proegssilb/lightsaber-hardware/system-board/system-board.kicad_pcb

## KiCad design system-board/system-board.kicad_pcb (2023-07-27)

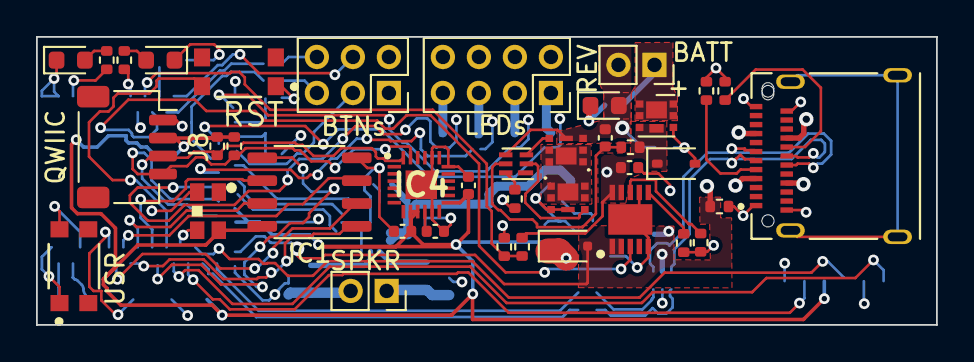
[picture p1: board system-board.kicad_pcb from above]

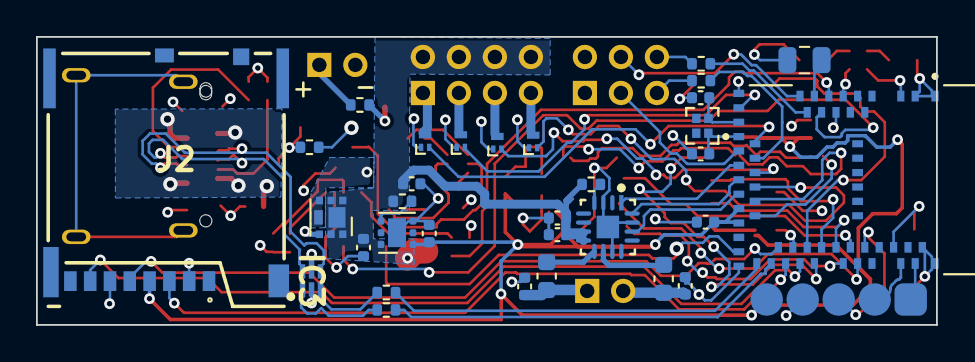
[picture p2: board system-board.kicad_pcb from below]

Board: 4 copper layers, 50.0 x 16.0 mm, 72 parts (33 on the bottom side), 74 nets.

Parts:
C1, C7, C9, C13: 10u; C_0402_1005Metric
C2, C3: 22p; C_0402_1005Metric
C4: 0.1 uF; C_0805_2012Metric
C5, C6: 220p; C_0402_1005Metric
C8: 100 nF; C_0402_1005Metric
C10, C14, C15, C16: 0.1 uF; C_0402_1005Metric
C11, C12: 4.7u; C_0402_1005Metric
D1: WS2812B-2020
D2: BLUE; LED_0603_1608Metric
D3: RED; LED_0603_1608Metric
D4: BZX38450; D_SOD-323
D5: REV; LED_0603_1608Metric
D6: PMEG1030EJ; D_SOD-323F
FB1, FB2: FB_Sm; C_0603_1608Metric
IC1: Flash_16Mb; SOP-8_3.9x4.9mm_P1.27mm
IC2: MCP73834T-FCI_MF; SON50P300X300X100-11N-D
IC3: HSP061-2M6; SON50P100X145X65-6N-D
IC4: ICM-20648; QFN40P300X300X95-25N-D
J1: BATT; PinSocket_1x02_P2.00mm_Vertical
J2: 503398-1892; Molex uSD Card Holder Push-Push 503398-1892
J3: DBG; Prog-Pads
J4: SPKR; PinSocket_1x02_P2.00mm_Vertical
J5: LEDs; PinSocket_2x04_P2.00mm_Vertical
J6: BTNs; PinSocket_2x03_P2.00mm_Vertical
J7: 105450-0101; AMPHENOL_12401832E402A
J8: QWIIC; JST_SH_SM04B-SRSS-TB_1x04-1MP_P1.00mm_Horizontal
Q1, Q4: DMP1012UFDF
Q2, Q3: SSM6K504NU.LF; SSM6K504NULF
Q5, Q6, Q7, Q8: PMZB290UNE2YL; Diodes_DFN1006-3
R1, R2: 22; R_0402_1005Metric
R3, R4, R10, R16, R17: 1k; R_0402_1005Metric
R5: 1M; R_0402_1005Metric
R6: 330; R_0402_1005Metric
R7: 2.2k; R_0402_1005Metric
R8, R20, R21: 2.0k; R_0402_1005Metric
R9: 10k; R_0402_1005Metric
R11: 200; R_0402_1005Metric
R12, R13, R14, R15: 100k; R_0402_1005Metric
R18, R19: 5k1; R_0402_1005Metric
SW1: RST; CK_Components-KMR231NG_LFS-MFG
SW2: USR; CK_Components-KMR231NG_LFS-MFG
U1: MDBT50Q-1MV2; XCVR_MDBT50Q-1MV2
U2: MAX98357AETE+T; Maxim_Integrated-T1633-4-0-V-IPC_C
U3: BQ29705DSER; WSON-6_1.5x1.5mm_P0.5mm
U4: TLV75733PDRV; WSON-6-1EP_2x2mm_P0.65mm_EP1x1.6mm
Y1: 32.768k; XTAL_ECS-.327-12.5-1210B-N-TR

Connections:
/A0: J6.3, U1.20 (P0.04/AIN2)
/A1: R17.2, U1.21 (P0.05/AIN3)
/A2: J6.4, U1.14 (P0.30/AIN6)
/A3: R16.2, U1.13 (P0.28/AIN4)
/A4: IC2.3 (STAT1), U1.11 (P0.02/AIN0)
/AREF: C4.2, U1.12 (P0.31/AIN7)
/Blade LED Out/Blade_1_Out: J5.1, Q5.3 (S)
/Blade LED Out/Blade_2_Out: J5.3, Q6.3 (S)
/Blade LED Out/Blade_3_Out: J5.5, Q7.3 (S)
/Blade LED Out/Blade_4_Out: J5.7, Q8.3 (S)
/CONN_USB_D+: IC3.1 (I/O1_1), R2.1
/CONN_USB_D-: IC3.3 (I/O2_1), R1.1
/D5: Q8.2 (G), U1.25 (P1.08)
/D6: Q7.2 (G), U1.23 (TRACECLK/P0.07)
/D9: Q5.2 (G), U1.19 (P0.26)
/D10: Q6.2 (G), U1.16 (P0.27)
/D11: U1.22 (P0.06), U2.1 (DIN)
/D12: U1.24 (P0.08), U2.16 (BCLK)
/D13: U1.26 (TRACEDATA3/P1.09), U2.14 (LRCLK)
/LED1: R4.2, U1.8 (P1.15)
/LED2: R3.2, U1.3 (P1.10)
/MCU_USB_D+: R2.2, U1.35 (D+)
/MCU_USB_D-: R1.2, U1.34 (D-)
/MISO: J2.7 (DAT0), U1.39 (P0.15)
/MOSI: J2.3 (CMD), U1.37 (P0.13)
/NEOPIX: D1.3 (DIN), U1.38 (P0.16)
/Power Management/BATT_FILTERED: C10.1, R6.2, U3.5 (BAT)
/Power Management/BATT_PROT_+: C9.1, D4.1 (K), IC2.9 (VBAT_1), IC2.10 (VBAT_2), Q1.3 (S), Q4.3 (S), R6.1, R12.1
/Power Management/BATT_RAW_+: J1.1, Q1.1 (D), R10.1
/Power Management/BATT_RAW_-: C10.2, D5.2 (A), J1.2, Q3.3 (S), R11.2, U3.4 (VSS)
/Power Management/VBUS: D6.2 (A), IC2.1 (VDD_1), IC2.2 (VDD_2), IC3.5 (VBUS), J7.A4 (VBUS_A), J7.A9 (VBUS_A), J7.B4 (VBUS_B), J7.B9 (VBUS_B), Q4.2 (G), R14.1, U1.32 (VBUS)
/QSPI_CS: IC1.1 (CS#), U1.44 (P0.20)
/QSPI_D0: IC1.5 (SI_(IO0)), U1.41 (P0.17)
/QSPI_D1: IC1.2 (SO_(IO1)), U1.46 (P0.22)
/QSPI_D2: IC1.3 (WP#_(IO2)), U1.45 (P0.23)
/QSPI_D3: IC1.7 (HOLD#_(IO3)), U1.43 (P0.21)
/QSPI_SCK: IC1.6 (SCLK), U1.42 (P0.19)
/RESET: SW1.2, U1.40 (~RESET/P0.18)
/SCK: J2.5 (CLK), U1.36 (P0.14)
/SCL: IC4.23 (SCL_/_SCLK), J8.4, R21.1, U1.27 (TRACEDATA2/P0.11)
/SDA: IC4.24 (SDA_/_SDI), J8.3, R20.2, U1.29 (TRACEDATA1/P0.12)
/SW0: J3.3, U1.47 (TRACEDATA0/P1.00)
/SWCLK: J3.1, U1.53 (SWDCLK)
/SWDIO: J3.2, U1.51 (SWDIO)
/SWITCH: SW2.2, U1.50 (P1.02)
/USB Connector/CC1: J7.A5 (CC1), R18.1
/USB Connector/CC2: J7.B5 (CC2), R19.1
/USB Connector/RAW_D+: IC3.6 (I/O1_2), J7.A6 (D1+), J7.B6 (D2+)
/USB Connector/RAW_D-: IC3.4 (I/O2_2), J7.A7 (D1-), J7.B7 (D2-)
/VDIV: R12.2, R13.1, U1.10 (P0.29/AIN5)
/XL1: C2.1, U1.17 (XL1/P0.00), Y1.2
/XL2: C3.1, U1.18 (XL2/P0.01), Y1.1
/i2s_amp/SOUND_OUT_N: FB1.2, U2.10 (OUTN)
/i2s_amp/SOUND_OUT_P: FB2.2, U2.9 (OUTP)
/i2s_amp/SPKR_N: C5.2, FB1.1, J4.2
/i2s_amp/SPKR_P: C6.2, FB2.1, J4.1
GND: C1.1, C2.2, C3.2, C4.1, C5.1, C6.1, C7.1, C8.2, C9.2, C11.2, C12.2, C13.2, C14.1, C15.2, C16.2, D1.2 (VSS), D2.1 (K), D3.1 (K), IC1.4 (VSS), IC2.5 (VSS), IC2.7 (~PG_(TE)), IC2.11 (EP), IC3.2 (GND), IC4.11 (FSYNC), IC4.18 (GND), IC4.20 (RESV), IC4.25 (EP), J2.2 (CD/DAT3), J2.6 (VSS), J3.4, J6.1, J6.2, J7.A1 (GND_A), J7.A12 (GND_A), J7.B1 (GND_B), J7.B12 (GND_B), J8.1, Q2.3 (S), Q5.1 (D), Q6.1 (D), Q7.1 (D), Q8.1 (D), R7.2, R8.2, R9.2, R13.2, R14.2, R18.2, R19.2, SW1.1, SW2.1, U1.1 (GND), U1.2 (GND), U1.9 (P0.03/AIN1), U1.15 (GND), U1.33 (GND), U1.54 (P0.10/NFC2), U1.55 (GND), U2.3 (GND), U2.11 (GND), U2.15 (GND), U2.17 (EP), U4.3 (GND), U4.7 (GND)
unnamed: D2.2 (A), R3.1
unnamed: D3.2 (A), R4.1
unnamed: D4.2 (A), Q1.2 (G), R11.1
unnamed: D5.1 (K), R10.2
unnamed: IC2.6 (PROG), R8.1
unnamed: IC2.8 (THERM), R9.1
unnamed: C15.1, IC4.10 (REGOUT)
unnamed: J6.5, R17.1
unnamed: J6.6, R16.1
unnamed: Q2.1 (D), Q3.1 (D)
unnamed: Q2.2 (G), U3.2 (Cout)
unnamed: Q3.2 (G), U3.3 (Dout)
unnamed: R5.1, U2.4 (~SD_MODE)
unnamed: R7.1, U3.6 (V-)
unnamed: R15.1, U4.4 (EN)
VCC: C1.2, C12.1, C14.2, C16.1, D1.4 (VDD), IC1.8 (VCC), IC4.8 (VDDIO), IC4.9 (SDO_/_AD0), IC4.13 (VDD), J2.4 (VDD), J3.5, J8.2, R20.1, R21.2, U1.28 (VDD), U1.30 (VDDH), U4.1 (OUT)
VDD: C7.2, C8.1, C11.1, C13.1, D6.1 (K), J5.2, J5.4, J5.6, J5.8, Q4.1 (D), R5.2, R15.2, U2.7 (VDD), U2.8 (VDD), U4.6 (IN)
