proegssilb/lightsaber-hardware/stacked-boards/stacked-boards.kicad_pcb

## KiCad design stacked-boards/stacked-boards.kicad_pcb (2023-06-28)

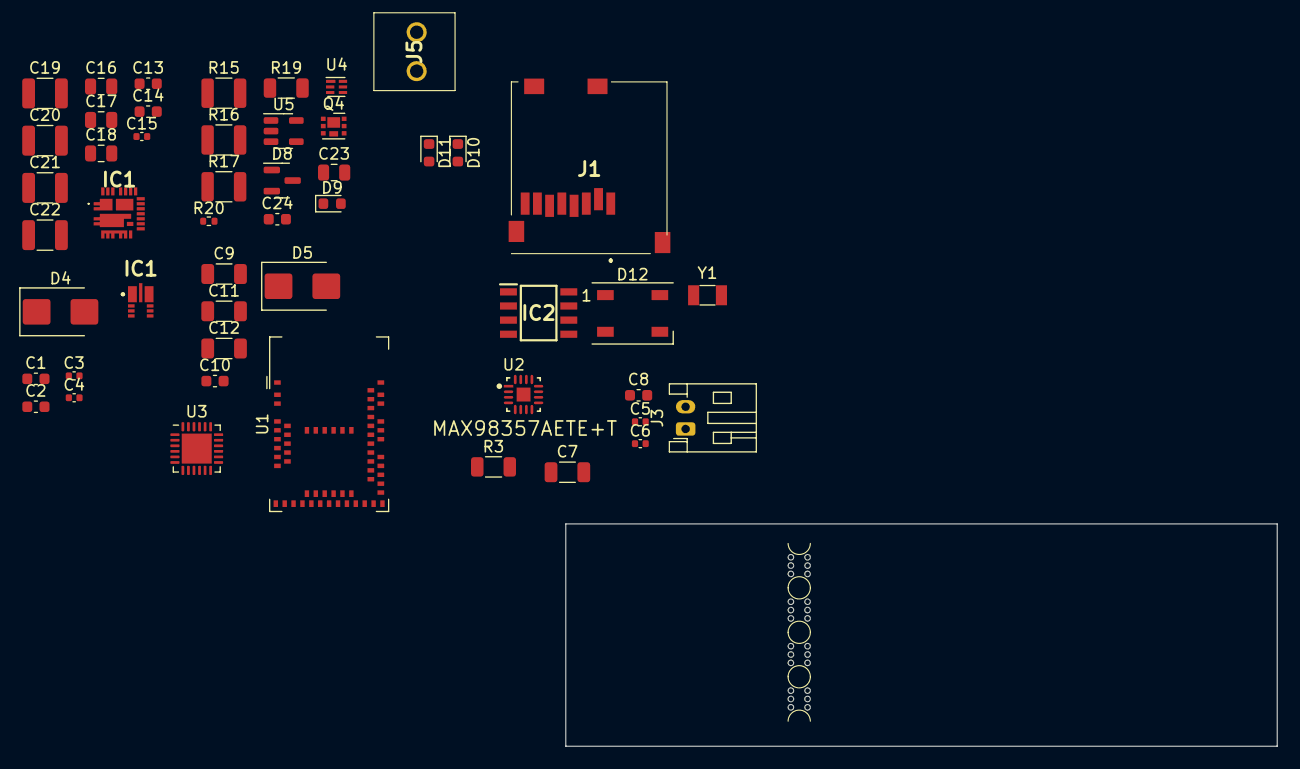
[picture p3: board stacked-boards.kicad_pcb from above]

Board: 2 copper layers, 64.0 x 20.0 mm, 54 parts (0 on the bottom side), 48 nets, no tracks yet.

Parts:
C1, C2: 10 uF; C_0603_1608Metric
C3, C4: 12 pF; C_0402_1005Metric
C5, C6: 220p; C_0402_1005Metric
C7: 10u; C_1206_3216Metric
C8: 0.1u; C_0603_1608Metric
C9, C11, C12: 1.0 uF; C_1206_3216Metric
C10, C13, C24: 0.1 uF; C_0603_1608Metric
C14: 100 nF; C_0603_1608Metric
C15: 1uF; C_0402_1005Metric
C16, C17: 22 uF; C_0805_2012Metric
C18: 4.7 uF; C_0805_2012Metric
C19: 220 uF; C_1210_3225Metric
C20, C21, C22: 220uF; C_1210_3225Metric
C23: 4.7uF; C_0805_2012Metric
D4, D5: VSSB7L45; D_SMB
D8: BAT54CLT3G; SOT-23
D9, D10: RED; LED_0603_1608Metric
D11: BLUE; LED_0603_1608Metric
D12: WS2812B; LED_WS2812B_PLCC4_5.0x5.0mm_P3.2mm
IC1: SIC437CED-T1-GE3; SIC437CEDT1GE3
IC1#2: AP63357QZV-7; AP63357QZV7
IC2: GD25Q16ETIGR; SOIC127P600X175-8N
J1: Micro_SD_Card; MEM20610118800A
J3: Conn_01x02_Socket; JST_PH_S2B-PH-K_1x02_P2.00mm_Horizontal
J5: Conn_Batt; 15465512
Q4: DMP1012UFDF; Diodes_UDFN2020-6_Type-F
R3: 1M; R_1206_3216Metric
R15: 330; R_1210_3225Metric
R16: 2.2k; R_1210_3225Metric
R17: 380; R_1210_3225Metric
R19: 470; R_1206_3216Metric
R20: 2k; R_0402_1005Metric
U1: MDBT50Q-1MV2; Raytac_MDBT50Q
U2: MAX98357AETE+T; Maxim_Integrated-T1633-4-0-V-IPC_C
U3: STUSB4500QTR; QFN-24-1EP_4x4mm_P0.5mm_EP2.7x2.7mm
U4: BQ29705DSER; WSON-6_1.5x1.5mm_P0.5mm
U5: MCP73831-2-OT; SOT-23-5
Y1: 32.768 kHz; Crystal_SMD_3215-2Pin_3.2x1.5mm
mouse-bite-2mm-slot, mouse-bite-2mm-slot#2, mouse-bite-2mm-slot#3, mouse-bite-2mm-slot#4: VAL**; mouse-bite-2mm-slot

Connections:
+3.3V: C7.2, C8.1, D5.1 (K), D12.1 (VDD), IC2.8 (VCC), J1.P4 (VDD), R3.2, U2.7 (VDD), U2.8 (VDD), U3.22 (VSYS)
+5V: C2.1, C19.1, C20.1, C21.1, C22.1, D4.2 (A), IC1.18 (VOUT), U1.30 (VDDH), U1.32 (VBUS)
/Amp/SPKR_N: C5.2, J3.2
/Amp/SPKR_P: C6.2, J3.1
/LED1: D10.2 (A), U1.8 (P1.15_(LS))
/LED2: D11.2 (A), U1.3 (P1.10_(LS))
/NEOPIX: D12.4 (DIN), U1.38 (P0.16_(HS))
/Power Management/Battery Handling/BATT_PROT_+: C23.1, D8.1 (K), Q4.3 (S), R15.1, U5.3 (V_{BAT})
/Power Management/Battery Handling/BATT_RAW_+: J5.2, Q4.1 (D), R17.1
/Power Management/Battery Handling/BATT_RAW_-: C24.2, D9.2 (A), J5.1, U4.4 (VSS)
/Power Management/Battery Handling/V_CHRG: D4.1 (K), U5.4 (V_{DD})
/Power Management/CHARGING: R19.1, U5.1 (STAT)
/Power Management/PD Negotiation/PD_POW_OUT: C10.1, C14.1, C16.1, C17.1, IC1.1 (VIN_1), IC1.2 (VIN_2), IC1.22 (VIN_3), IC1.26 (VIN_4)
/Power Management/PD Negotiation/USB_CC1: U3.1 (CC1DB), U3.2 (CC1)
/Power Management/PD Negotiation/USB_CC2: U3.4 (CC2), U3.5 (CC2DB)
/Power Management/PD Negotiation/V_USB_PORT: C11.1, U3.24 (VDD)
/QSPI_CS: IC2.1 (CS#), U1.44 (P0.20_(HS))
/QSPI_D0: IC2.5 (SI_(IO0)), U1.41 (P0.17_(HS))
/QSPI_D1: IC2.2 (SO_(IO1)), U1.46 (P0.22/QSPI)
/QSPI_D2: IC2.3 (WP#_(IO2)), U1.45 (P0.23/QSPI)
/QSPI_D3: IC2.7 (HOLD#_(IO3)), U1.43 (P0.21/QSPI)
/QSPI_SCK: IC2.6 (SCLK), U1.42 (P0.19/QSPI_SCK)
Earth: C16.2, C17.2, C18.2, C19.2, C20.2, C21.2, C22.2
GND: C1.1, C2.2, C3.2, C4.2, C5.1, C6.1, C7.1, C8.2, C9.1, C11.2, C12.2, C14.2, C15.2, C23.2, D10.1 (K), D11.1 (K), D12.3 (VSS), IC1.3 (PGND_1), IC1.4 (PGND_2), IC1.13 (PGND_3), IC1.16 (AGND_1), IC1.25 (AGND_2), IC1.27 (PGND_4), IC1.29 (PGND_5), IC1#2.4 (COMP), IC1#2.8 (GND), IC2.4 (VSS), J1.CD1 (CARD_DETECT_1), J1.G1 (GND_1), J1.G2 (GND_2), J1.P1 (DAT2), J1.P6 (VSS), R16.2, R20.2, U1.1 (GND), U1.2 (GND), U1.15 (GND), U1.33 (GND), U1.55 (GND), U2.3 (GND), U2.11 (GND), U2.15 (GND), U2.17 (EP), U3.10 (GND), U3.12 (ADDR0), U3.13 (ADDR1), U3.25 (GND), U5.2 (V_{SS})
I2C_SCL: U1.27 (TRACEDATA2/P0.11), U3.7 (SCL)
I2C_SDA: U1.29 (TRACEDATA1/P0.12), U3.8 (SDA)
MISO/CIPO: J1.P7 (DAT0), U1.39 (P0.15_(HS))
MOSI/COPI: J1.P3 (CMD), U1.37 (P0.13_(HS))
unnamed: C12.1, D5.2 (A), U3.23 (VREG_2V7)
unnamed: D8.2 (A), Q4.2 (G)
unnamed: D9.1 (K), R17.2
unnamed: C13.1, IC1.23 (BOOT)
unnamed: IC1.19 (EN), IC1#2.2 (EN)
unnamed: IC1.17 (FB), IC1#2.3 (FB)
unnamed: IC1.5 (SW_1), IC1.6 (SW_2), IC1.7 (SW_3), IC1.8 (SW_4), IC1.9 (SW_5), IC1.30 (SW_6)
unnamed: C15.1, IC1.15 (VDD)
unnamed: C18.1, IC1.12 (VDRV)
unnamed: C1.2, U1.28 (VDD)
unnamed: C3.1, U1.17 (XL1/P0.00), Y1.2
unnamed: C4.1, U1.18 (XL2/P0.01), Y1.1
unnamed: R3.1, U2.4 (~SD_MODE)
unnamed: C9.2, U3.21 (VREG_1V2)
unnamed: C24.1, R15.2, U4.5 (BAT)
unnamed: R16.1, U4.6 (V-)
unnamed: R20.1, U5.5 (PROG)
SD_CardDetect: J1.CD2 (CARD_DETECT_2), U1.6 (P1.13_(LS))
SD_ChipSel#: J1.P2 (CD/DAT3), U1.7 (P1.14_(LS))
SPI_CLK: J1.P5 (CLK), U1.36 (P0.14_(HS))
