proegssilb/lightsaber-hardware/(commit log)

2023-07-05 Do some calculations, overhaul system-board to be a single board, not a Feather add-on.
    [LED Resistor Math.ods, Switching Power Regulator Component Selection.ods, button-ports.kicad_sch, i2s_amp.kicad_sch, led-out.kicad_sch, power.kicad_sch, system-board.kicad_pcb, system-board.kicad_sch]
2023-07-05 Add most of the missing 3D models, some tweaks
    [system-board.kicad_pcb]
2023-07-05 Add imported footprints & models
    [system-board.kicad_pcb, system-board.kicad_sch]
2023-07-06 Small tweaks, add a license.
    [system-board.kicad_pcb]
2023-07-07 First attempt
    [button-ports.kicad_sch, i2s_amp.kicad_sch, led-out.kicad_sch, system-board.kicad_pcb, system-board.kicad_sch]
2023-07-10 Redo system-board PCB to use fewer connectors
    [button-ports.kicad_sch, i2s_amp.kicad_sch, led-out.kicad_sch, power.kicad_sch, system-board.kicad_pcb, system-board.kicad_sch, usb-conn.kicad_sch]
2023-07-21 Yet another PCB Revision
    [button-ports.kicad_sch, i2s_amp.kicad_sch, led-out.kicad_sch, power.kicad_sch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]
2023-07-27 Redo design again
    [Switching Power Regulator Component Selection.ods, button-ports.kicad_sch, i2c_devs.kicad_sch, i2s_amp.kicad_sch, led-out.kicad_sch, power.kicad_sch, system-board.kicad_pcb, system-board.kicad_sch]
